niklasdathe/Riecher/(commit log)

2025-11-07 Add Zigbee sensor functionality for SEN66
2026-05-18 Enhance README with images and additional details
    Added images and details to the mechanicals and manufacturing sections. Updated PCB description and added FAQ section.
